salveoo/voronmods/Switchwire Magprobe/readme.md

# Magprobe for Voron Switchwire conversion

:heavy_exclamation_mark: **if you have a stock Switchwire go to >** [Magprobe for stock Voron Switchwire](https://github.com/salveoo/voronmods/blob/main/Switchwire%20Magprobe/readme.md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)

This mod allows you to use a mechanical switch as a probe on your Switchwire conversion without losing any print volume. \
_This mod was created remixing two mods: \
 • [Klicky](https://github.com/jlas1/Klicky-Probe) \
 • [SideSwipe](https://github.com/oldfar-t/Side-Swipe-Magnetic-Probe)_

<p align="center">
  
</p>

## Probe alternative

<p align="center">
  
</p>

You can use the Reverse probe with this mod. **Print probe_arm_REVERSE.stl instead of probe_arm.stl.** \
Check [Reverse probe](https://github.com/salveoo/voronmods/tree/main/reverse_probe) repo for more informations.

## BOM

#### Motion
* 1x SG90 9g servo

#### Probe
* 1x mouse switch (eg. Omron D2F-5)

#### Fasteners
* 3x M3x8 SHCS
* 2x M3x12 SHCS
* 2x M3 t-nut for 2020 extrusion
* 4x M2x10 Self-Tapping Screw

#### Magnets
* 5x 6mmx3mm magnets (tested working with N45 magnets)

## Assembly

### Servo bracket assembly
* Secure the servo motor using 2x m2x10mm self tapping
* Use 1x m3x8mm and screw it in to the probe arm
* Use the small screw provided with the servo to secure the arm in place

<p align="center">
  
</p>

* Use 2x m3x8mm to secure it on the side of the bed.

<p align="center">
  
</p>

:heavy_exclamation_mark: **Align the bed surface with the servo holder**
<p align="center">
  
</p>

### Probe assembly

Assembly Video (https://youtu.be/O1bFm4f67_E?t=41 "YouTube")

After assembling the probe, check continuity with a multimeter. Follow this from Sideswipe's Github if you have continuity issues: [Probe troubleshooting](https://github.com/oldfar-t/Side-Swipe-Magnetic-Probe#troubleshooting)

### Carriage mount assembly
1. The carriage mount is remixed from Klicky mod mount. Use 22-24 awg wires
2. Make sure you have enought copper exposed to make good contact
3. Insert magnets, then test continuity with a multimeter. Use 2x m3x12mm to bolt it on the carriage

<p float="left">
  
   
  
</p>

## Macros
I have an Artillery Genius to Switchwire conversion so the coordinates of the macros could be slightly different for an Ender 3 conversion. If you get the macros working with an Ender 3 conversion text me on Discord Salveo#6988.

## Z endstop holder
To make this mod work you need something to home the Z axis. You can use this switch holder, it triggers with _Z_bearing block_. \
You'll need:
* 1x M5 t-nut for 2020 extrusion
* 1x M5x10 BHCS
* 2x M2x10 Self-Tapping Screw
* 1x endstop switch (eg. Omron D2F-5L)

<p float="left">
  
   
</p>

# Magprobe for stock Voron Switchwire
:heavy_exclamation_mark: **if you have a Switchwire Conversion go to >** [Magprobe for Voron Switchwire conversion](https://github.com/salveoo/voronmods/tree/main/Switchwire%20Magprobe#magprobe-for-voron-switchwire-conversion)

:heavy_exclamation_mark: **Files and macros for stock Switchwire have not been tested**, _if you test them and want to give a feedback text me on Discord Salveo#6988_

Magprobe for stock Switchwire is easy to mount and bolts under the _left Z carriage stop._. The print volume remains the same with this mod installed.

<p align="center">
  
</p>

## Probe alternative

<p align="center">
  
</p>

You can use the Reverse probe with this mod. **Print probe_arm_REVERSE.stl instead of probe_arm.stl.** \
Check [Reverse probe](https://github.com/salveoo/voronmods/tree/main/reverse_probe) repo for more informations.

## BOM

#### Motion
* 1x SG90 9g servo

#### Probe
* 1x mouse switch (eg. Omron D2F-5)

#### Fasteners
* 1x M3x8 SHCS
* 2x M3x12 SHCS
* 1x M5x10 BHCS
* 1x M5 t-nut for 3030 extrusion
* 4x M2x10 Self-Tapping Screw

#### Magnets
* 5x 6mmx3mm magnets (tested working with N45 magnets)

## Assembly

### Servo bracket assembly
* Secure the servo motor using 2x m2x10mm self tapping
* Use 1x m3x8mm and screw it in to the probe arm
* Use the small screw provided with the servo to secure the arm in place

<p align="center">
  
</p>

* Use 1x m5x10mm to secure it on the side of the bed.

<p align="center">
  
</p>

<p align="center">
  
</p>

:heavy_exclamation_mark: **Align the bed surface with the servo holder**
<p align="center">
  
</p>

### Probe assembly

Assembly Video (https://youtu.be/O1bFm4f67_E?t=41 "YouTube")

After assembling the probe, check continuity with a multimeter. Follow this from Sideswipe's Github if you have continuity issues: [Probe troubleshooting](https://github.com/oldfar-t/Side-Swipe-Magnetic-Probe#troubleshooting)

### Carriage mount assembly
1. The carriage mount is remixed from Klicky mod mount. Use 22-24 awg wires
2. Make sure you have enought copper exposed to make good contact
3. Insert magnets, then test continuity with a multimeter. Use 2x m3x12mm to bolt it on the carriage

<p float="left">
  
   
  
</p>

## Z endstop holder
To make this mod work you need something to home the Z axis. You can use this switch holder, it triggers with _Z_bearing block_. \
You'll need:
* 1x M5 t-nut for 3030 extrusion
* 1x M5x10 BHCS
* 2x M2x10 Self-Tapping Screw
* 1x endstop switch (eg. Omron D2F-5L) \

<p float="left">
  
   
</p>
