salveoo/voronmods/reverse_probe/readme.md

# Reverse probe (beta)
**Reverse probe** is a mechanical probe based on Voron's Z endstop.
<p align="center">
  
</p>

## BOM

* 1x mouse switch (eg. Omron D2F-5)
* 2x M3x20 SHCS
* 2x M2x10 Self-Tapping Screw
* 1x 20T GT2 pulley
* 5x30mm smooth pin
* 2x 6x3mm magnets (tested working with N45 magnets)

## Assembly
*click to see the video*

<p align="center">
  
</p>

## Macros
*As you can see in the assembly video I have a particular setup, so I can't provide macros.* \
You can watch [this part of the assembly video](https://youtu.be/dyCEBMJFdaU?t=92) to have an idea of the **docking and undocking sequence.**

### probe offset
**z_offset: 6.5 \
x_offset: 0 \
y_offset: 22**
