salveoo/voronmods/reverse_probe/CAD/reverse_probe_CAD.step

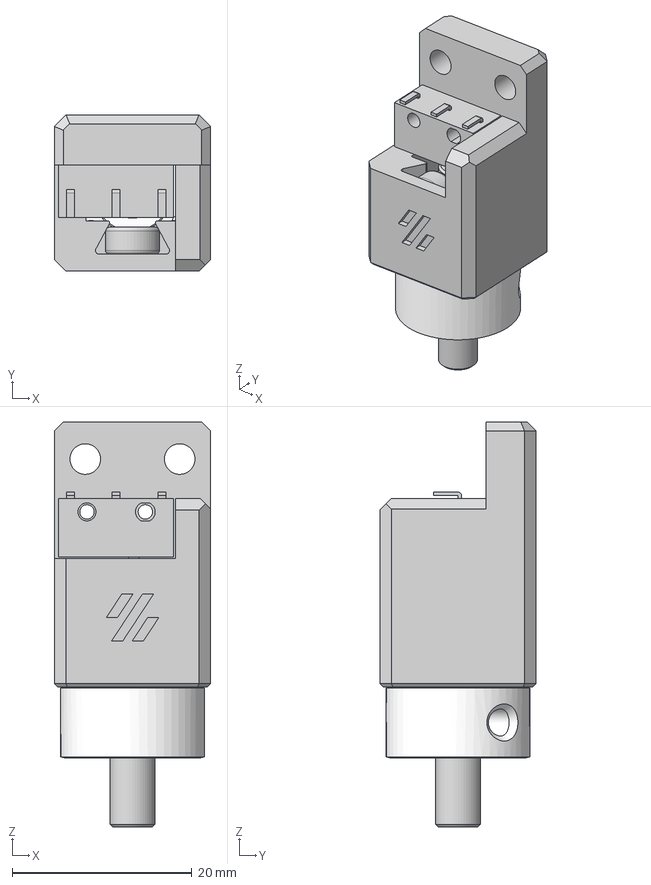
[picture p1: CAD file, 2022-09-02]
reverse_probe/CAD/reverse_probe_CAD.step
17.4 x 17.4 x 45.1 mm
Omron_D2F_F
5x33 Shaft
GT2 20T 6mm Deflanged
