salveoo/voronmods/reverse_probe/STLs/probe_holder.stl

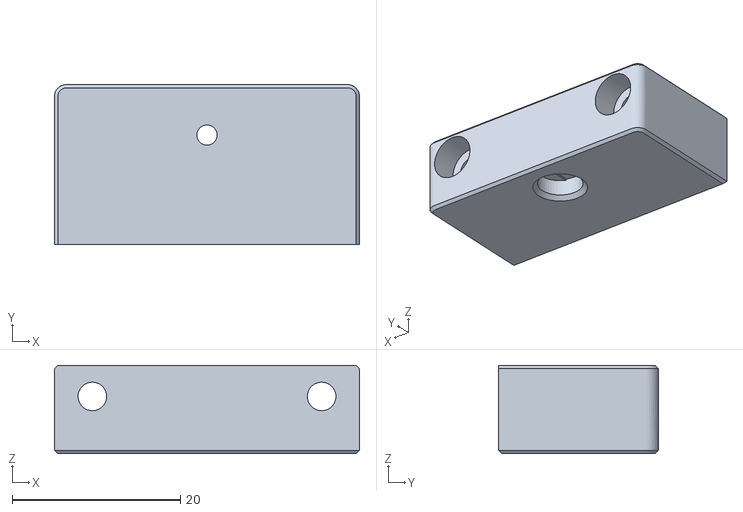
[picture p2: CAD file, 2022-09-02]
reverse_probe/STLs/probe_holder.stl
36.3 x 19.0 x 10.5
