salveoo/voronmods/Switchwire Magprobe/CAD/salveo_magprobe_STEP.step

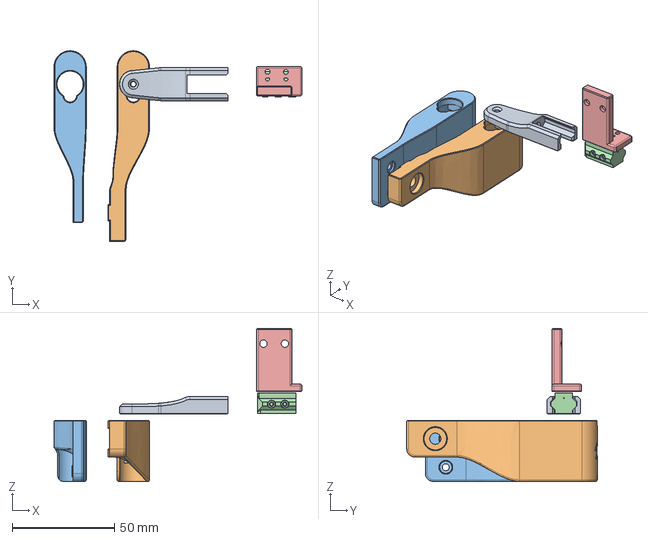
[picture p3: CAD file, 2022-04-21]
Switchwire Magprobe/CAD/salveo_magprobe_STEP.step
121.4 x 93.3 x 75.0 mm
