salveoo/voronmods/Switchwire Magprobe/STL/SW_conversion/z_endstop_conversion.stl

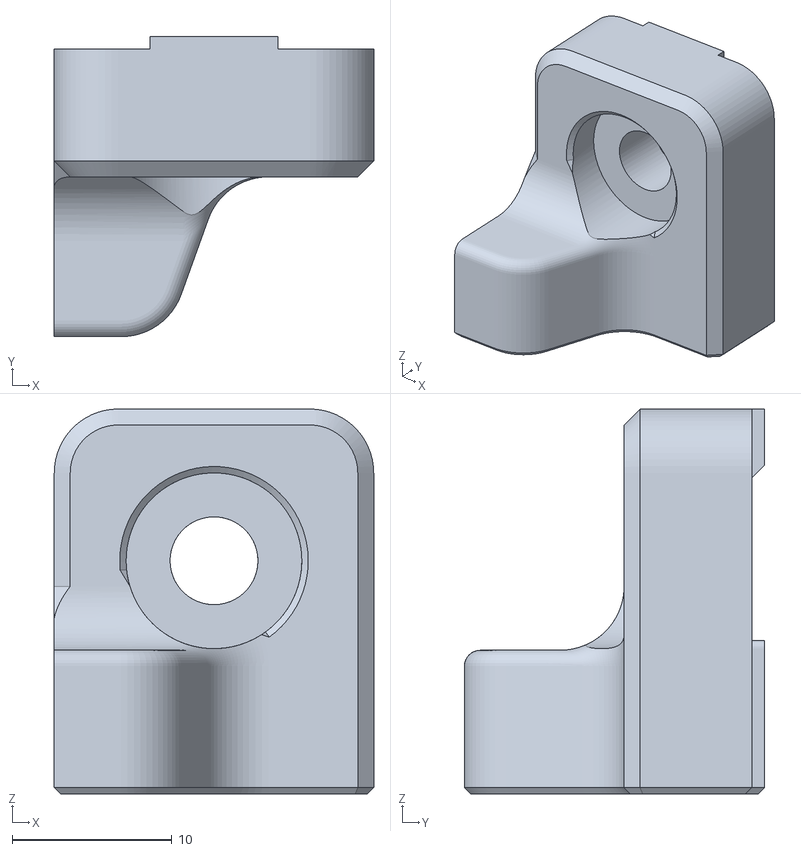
[picture p4: CAD file, 2022-02-04]
Switchwire Magprobe/STL/SW_conversion/z_endstop_conversion.stl
20.0 x 18.8 x 24.1
