salveoo/voronmods/Switchwire Magprobe/STL/SW_stock/probe_arm_REVERSE.stl

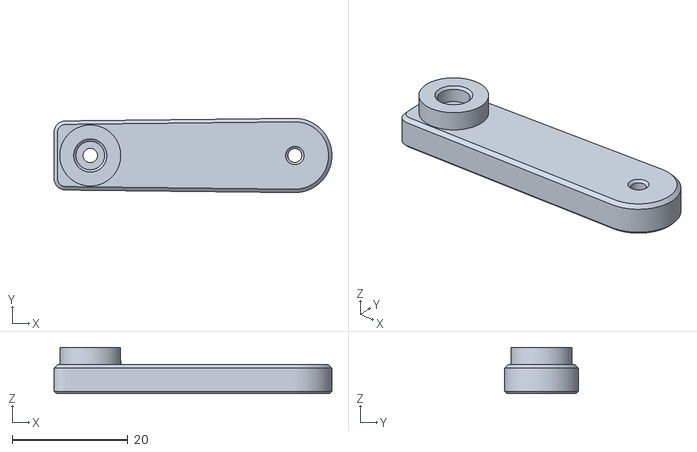
[picture p5: CAD file, 2022-10-30]
Switchwire Magprobe/STL/SW_stock/probe_arm_REVERSE.stl
48.1 x 12.8 x 8.00
