salveoo/voronmods/reverse_probe/STLs/probe_body.stl

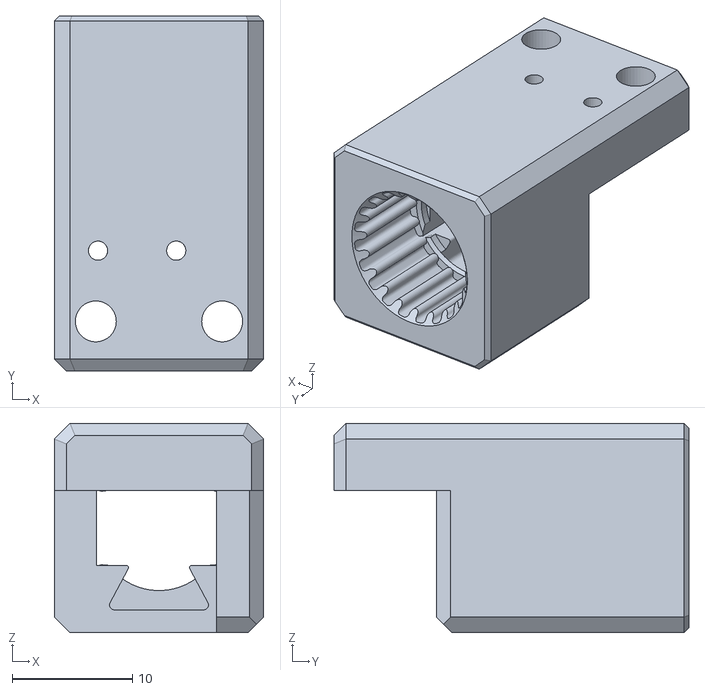
[picture p6: CAD file, 2022-09-02]
reverse_probe/STLs/probe_body.stl
17.4 x 29.5 x 17.4
