salveoo/voronmods/Switchwire Magprobe/STL/SW_conversion/carriage_mount.stl

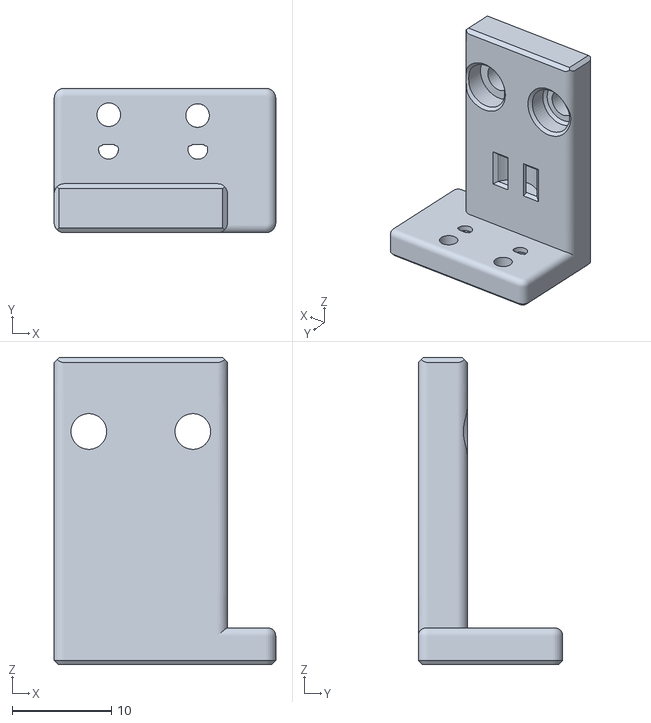
[picture p7: CAD file, 2022-01-28]
Switchwire Magprobe/STL/SW_conversion/carriage_mount.stl
22.4 x 14.6 x 31.0
