salveoo/voronmods/Switchwire Magprobe/STL/SW_stock/z_endstop_stock_rail.stl

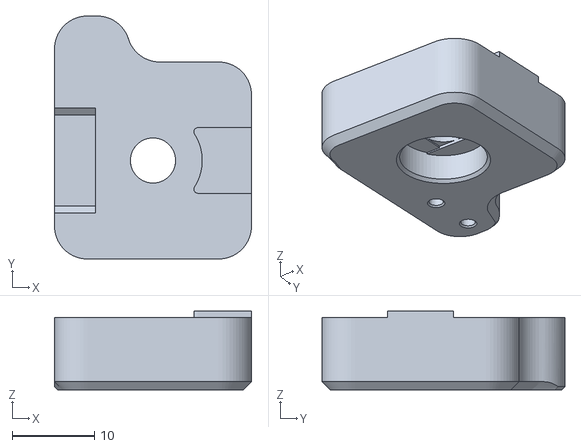
[picture p8: CAD file, 2022-02-24]
Switchwire Magprobe/STL/SW_stock/z_endstop_stock_rail.stl
24.0 x 29.6 x 9.60
