salveoo/voronmods/Switchwire Magprobe/STL/SW_conversion/servo_holder_conversion.stl

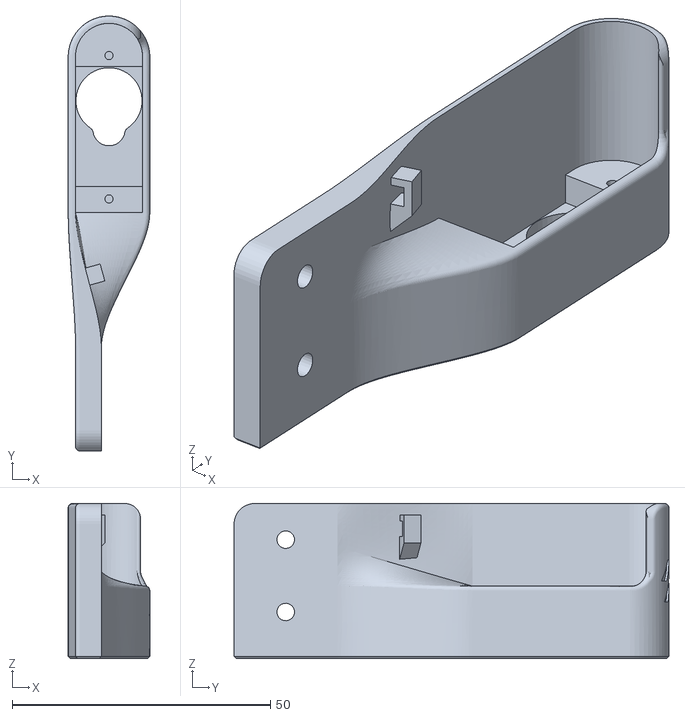
[picture p9: CAD file, 2022-01-23]
Switchwire Magprobe/STL/SW_conversion/servo_holder_conversion.stl
15.8 x 84.2 x 30.0
