salveoo/voronmods/Switchwire Magprobe/STL/SW_stock/z_endstop_stock.stl

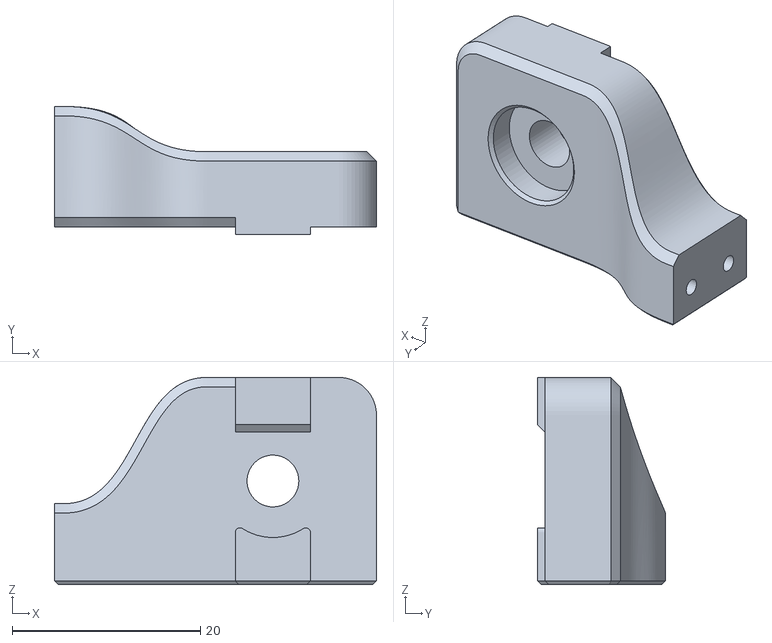
[picture p10: CAD file, 2022-02-04]
Switchwire Magprobe/STL/SW_stock/z_endstop_stock.stl
34.2 x 13.6 x 22.0
