salveoo/voronmods/Switchwire Magprobe/STL/SW_conversion/probe_arm.stl

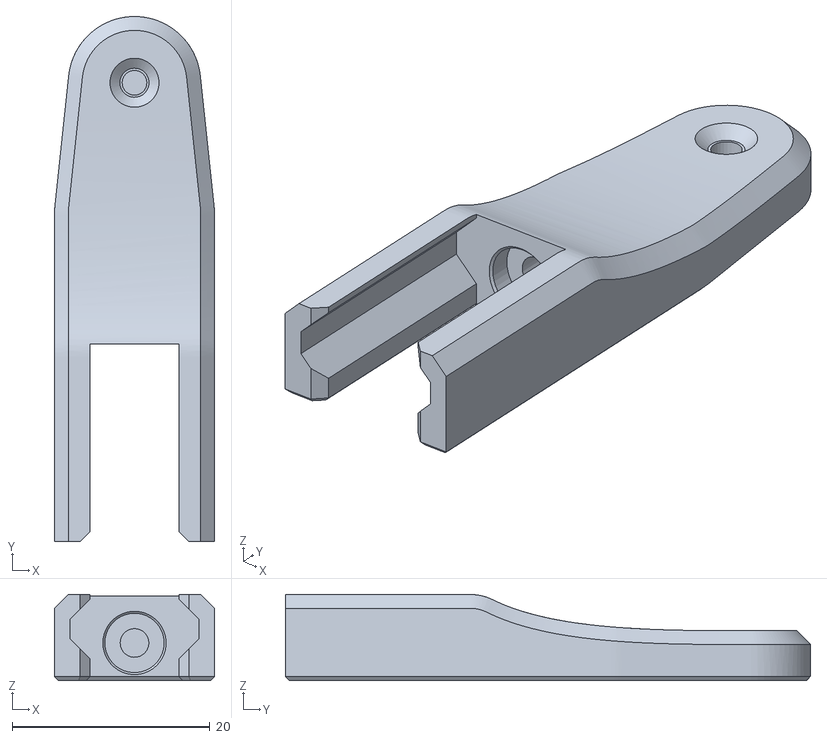
[picture p11: CAD file, 2022-01-18]
Switchwire Magprobe/STL/SW_conversion/probe_arm.stl
16.2 x 53.1 x 8.70
