salveoo/voronmods/Switchwire Magprobe/STL/SW_conversion/probe_block.stl

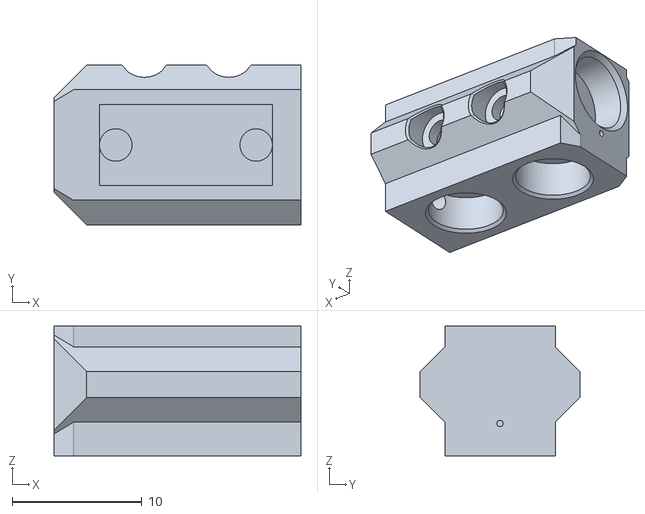
[picture p12: CAD file, 2022-01-16]
Switchwire Magprobe/STL/SW_conversion/probe_block.stl
19.0 x 12.3 x 10.0
