salveoo/voronmods/Switchwire Magprobe/STL/SW_stock/servo_holder_stock.stl

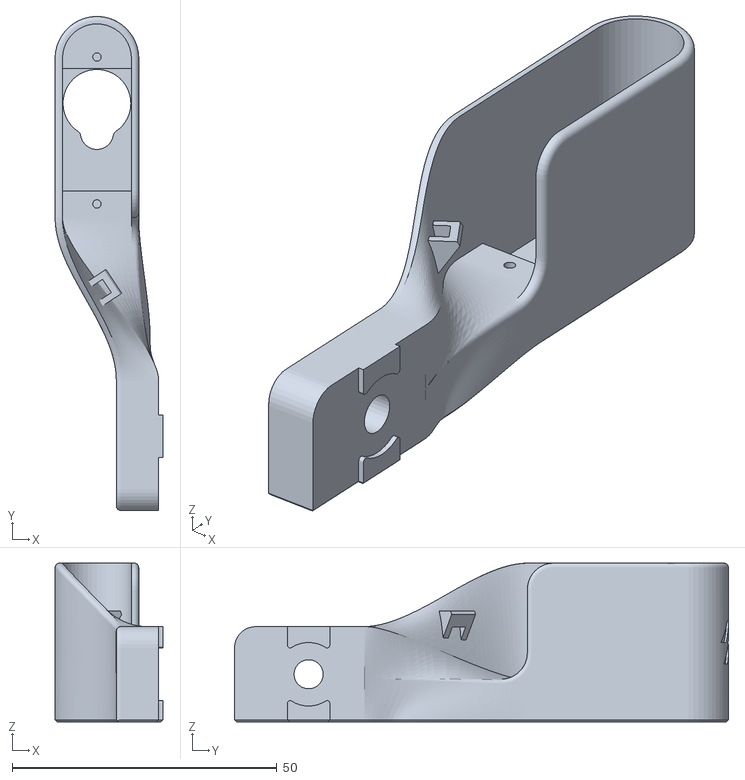
[picture p13: CAD file, 2022-01-23]
Switchwire Magprobe/STL/SW_stock/servo_holder_stock.stl
20.4 x 93.3 x 30.0
