salveoo/voronmods/(list of files, cad)

Other CAD files:
Switchwire Magprobe/CAD/salveo_magprobe_f3d.f3d
