salveoo/voronmods/(threads)

Thread 1 (2022-02-22):

Quick question

acosano, 2022-02-22:
Hi. I just was wondering if is OK with you if  I can do some modifications and adapt it to Euclid-Probe. The idea I have is to shorten the arm and have different holder adaptors for it. You could have one for Klicky, Magprobe , Euclid  etc...
I will acknowledge that the main idea and files comes from you and that I only add the changes for the Euclid. I also don't mind if you one to do the Euclid adapter.
Let me know what you think and sorry I could not find any other way to contact you if not opining a issue.

salveoo, 2022-02-22:
Hey, it's a good idea to adapt it to different probes. You can contact me on discord salveo#6988 so we can work out some solutions.

Thread 2 (2022-02-23):

Z endstop switch question

XEL-Maker, 2022-02-23:
Hi I have a idea about Z endstop holde.
The reason for using the current z-endstop switch is that the probe is not attached to the extruder at first.
If the probe is attached to the extruder, wouldn't it be okay without a z-stop switch?
Currently, I have completed the chamber installation, so it is very difficult to install the z-endstop position.
Or, it would be nice to combine modeling with the lm guide stopper.

salveoo, 2022-02-23:
You could use this probe as a virtual endstop but this requires the probe to be attached before homing. You can program the printer to get the probe when the print stops but as soon as you have a shutdown with the probe de attached you'll have to attach it manually. I don't think this is convenient in any way. Is it really that hard to bolt the Z endstop? Can't you pull the gantry up and screw it in place?

XEL-Maker, 2022-02-24:
I did a simulation once and it was pretty hard.
If the gantry is raised, assembly is possible, but it is very difficult to align the z-endstop with the z-endstop triggered at that location when the z-endstop is installed.
https://github.com/salveoo/voronmods/blob/main/Switchwire%20Magprobe/readme.md#z-endstop-holder-1
There are no wires & acrylic wall (on the right side) in the photo here, but my Switchwire has it.
Disassembling the chamber can also be a solution, but it can cause a lot of things (I know the chamber is not completely sealed, but it's quite difficult to disassemble and reassemble).
Or, I think it might be faster to redesigning the LM stopper while using a virtual probe.
Another way is to shift the z-axis to the left. However, this leads to wiring complexity. This is because smps occupies its place.

salveoo, 2022-02-24:
I redesigned the Z-endstop holder to trigger with the rail carriage. This endstop holder has a slot so you can adjust it by sliding it on the rail. Replace left z_carriage_stop with it. Way easier to mount.
Let me know if you install it => https://github.com/salveoo/voronmods/blob/main/Switchwire%20Magprobe/STL/SW_stock/z_endstop_stock_rail.stl

<p align="center">
  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
</p>

<p align="center">
  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
</p>

XEL-Maker, 2022-02-25:
Thank you so much for redesigning the z-axis.
I will apply it as soon as possible.
I will close this issue unless there is a problem.

Closed 2022-02-25.

Thread 6 (2022-04-15):

Fit of probe_arm

strayr, 2022-04-15:
I'm having trouble getting probe_arm.stl to fit on my servo, is there any chance of cad files or STEP so i can modify the parts slightly?

salveoo, 2022-04-21:
I released the cad of the project. Enjoy!

Closed 2022-04-21.

Thread 7 (2022-04-23):

servo arm original dimension

XEL-Maker, 2022-04-23:
Hi!
 I want to get the original cad file of servo arm for build euclid probe.

I used this mode until recently, but errors often occurred in mesh measurements due to poor contact.
I decided to change it to Euclidean probe, but I considered the problem of receiving the probe, and as a result, I thought it would be possible to change the servo_arm.

salveoo, 2022-04-23:
Hi! You can find the cad here: https://github.com/salveoo/voronmods/tree/main/Switchwire%20Magprobe/CAD .

XEL-Maker, 2022-04-23:
Thanks a lot i'll try to build.

Closed 2022-04-23.
