salveoo/voronmods/(commit log)

2022-01-15 Rename Sw conversion Sideswipe/ee.txt to Switchwire Sideswipe
2022-01-15 Rename Sw conversion Sideswipe/readme.md to Switchwire Sideswipe/readme.md
2022-01-15 Rename Switchwire Sideswipe/readme.md to Switchwire Magprobe/readme.md
2022-01-16 print settings
2022-01-18 addressing magnet too strong on probe arm
2022-01-18 updated probe_arm.stl
    [probe_arm.stl]
2022-01-18 readme bom update
2022-01-19 updated carriage mount
    [carriage_mount.stl]
2022-01-19 added z endstop mount
    [z_endstop_mount.stl]
2022-01-22 solving collision issue with triano mod
    [servo_holder_conversion.stl]
2022-01-22 Solving collision with Triano's conversion
    [servo_holder_conversion.stl]
2022-01-23 updated holder for stock
    [servo_holder_stock.stl]
2022-01-28 corrected geometry, assisted bridging added
    [carriage_mount.stl]
2022-02-03 updated z endstop mount
    [z_endstop_conversion.stl]
2022-02-03 added z endstop for stock
    [z_endstop_stock.stl]
2022-02-04 new z endstop
    [z_endstop_conversion.stl]
2022-02-04 updated stock z endstop
    [z_endstop_stock.stl]
2022-02-24 new Z endstop carriage
    [z_endstop_stock_rail.stl]
2022-03-02 Update Sw_magprobe.cfg
    upload my cfg
    [Sw_magprobe.cfg]
2022-03-03 Update Sw_magprobe.cfg
    add safety option for z height to 10
    [Sw_magprobe.cfg]
2022-04-21 added CAD files
2022-09-02 Add files via upload
    STLs upload
    [probe_body.stl, probe_holder.stl]
2022-09-02 CAD upload
    [reverse_probe_CAD.step]
